AlpenglowIndustries/Alpenglow_RadiantRainbow_PCB/README.md

# Alpenglow_RadiantRainbow_PCB
Cheerful rainbow great for beginning soldering.  Made with KiCad 6
