AlpenglowIndustries/Alpenglow_RadiantRainbow_PCB/Artwork/Blush Bigger Flipped.png

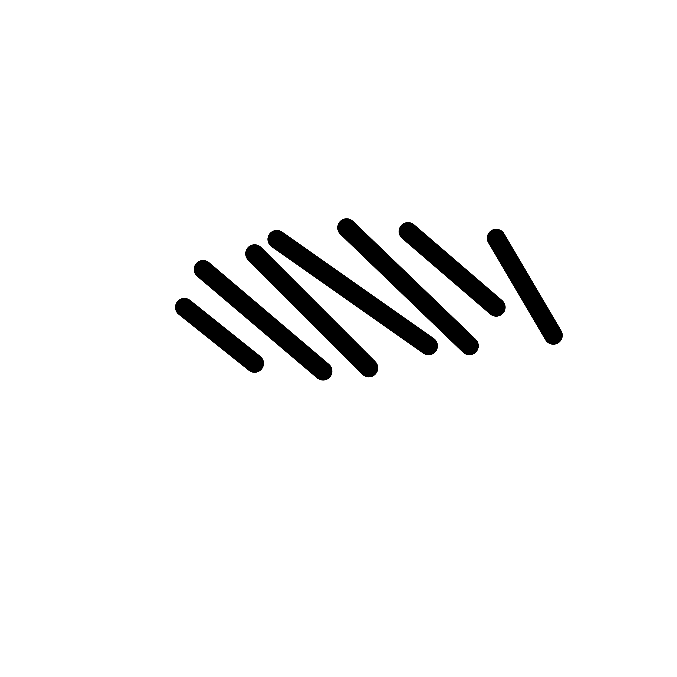
Artwork/Blush Bigger Flipped.png
