AlpenglowIndustries/Alpenglow_RadiantRainbow_PCB/Artwork/Blush Bigger.png

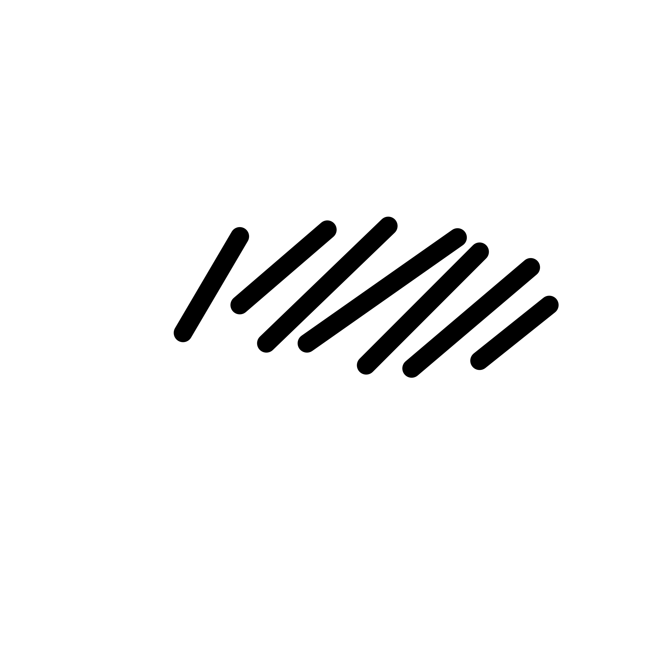
Artwork/Blush Bigger.png
