AlpenglowIndustries/Alpenglow_RadiantRainbow_PCB/Artwork/Cloud Pair for Silk.png

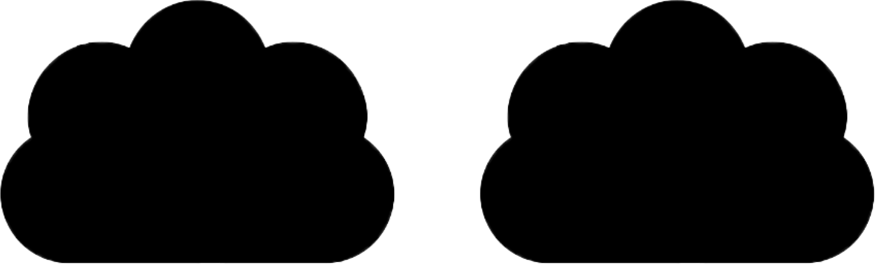
Artwork/Cloud Pair for Silk.png
