AlpenglowIndustries/Alpenglow_RadiantRainbow_PCB/Artwork/raibow lines.png

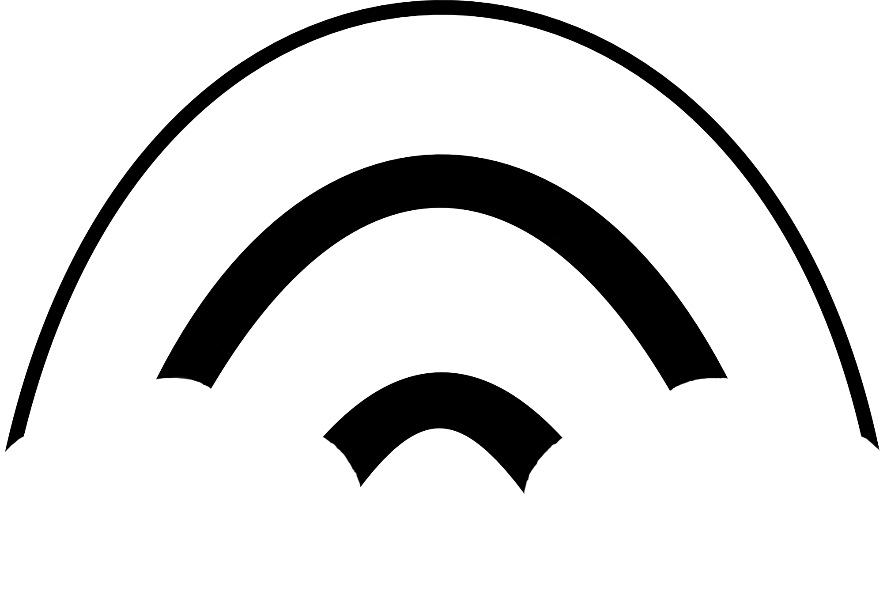
Artwork/raibow lines.png
