AlpenglowIndustries/Alpenglow_RadiantRainbow_PCB/Artwork/Rainbow Filled In More Space for LEDs.png

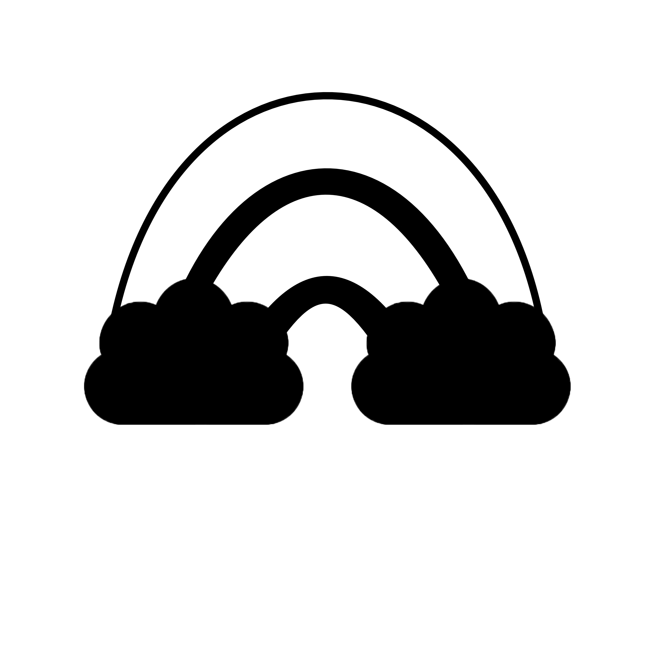
Artwork/Rainbow Filled In More Space for LEDs.png
