AlpenglowIndustries/Alpenglow_RadiantRainbow_PCB/Artwork/RAR board name font 2 lines.png

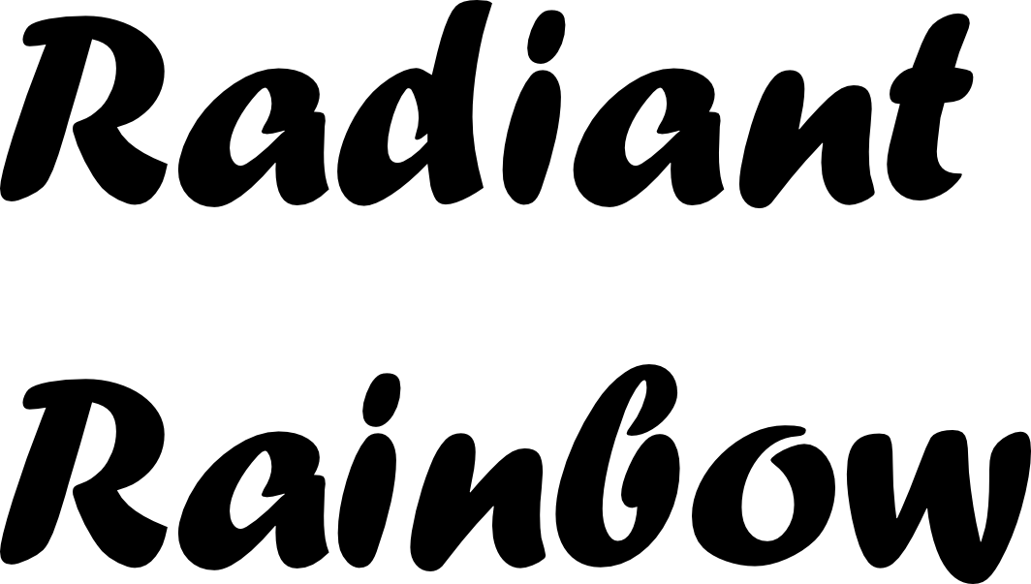
Artwork/RAR board name font 2 lines.png
