AlpenglowIndustries/Alpenglow_RadiantRainbow_PCB/Artwork/RAR board name font.png

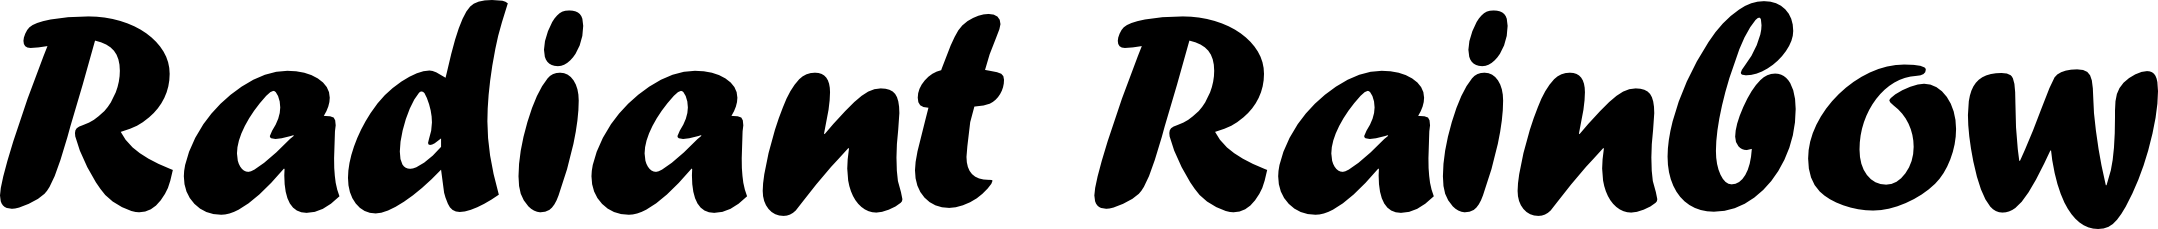
Artwork/RAR board name font.png
