AlpenglowIndustries/Alpenglow_RadiantRainbow_PCB/Alpenglow_RadiantRainbow_PCB.pdf

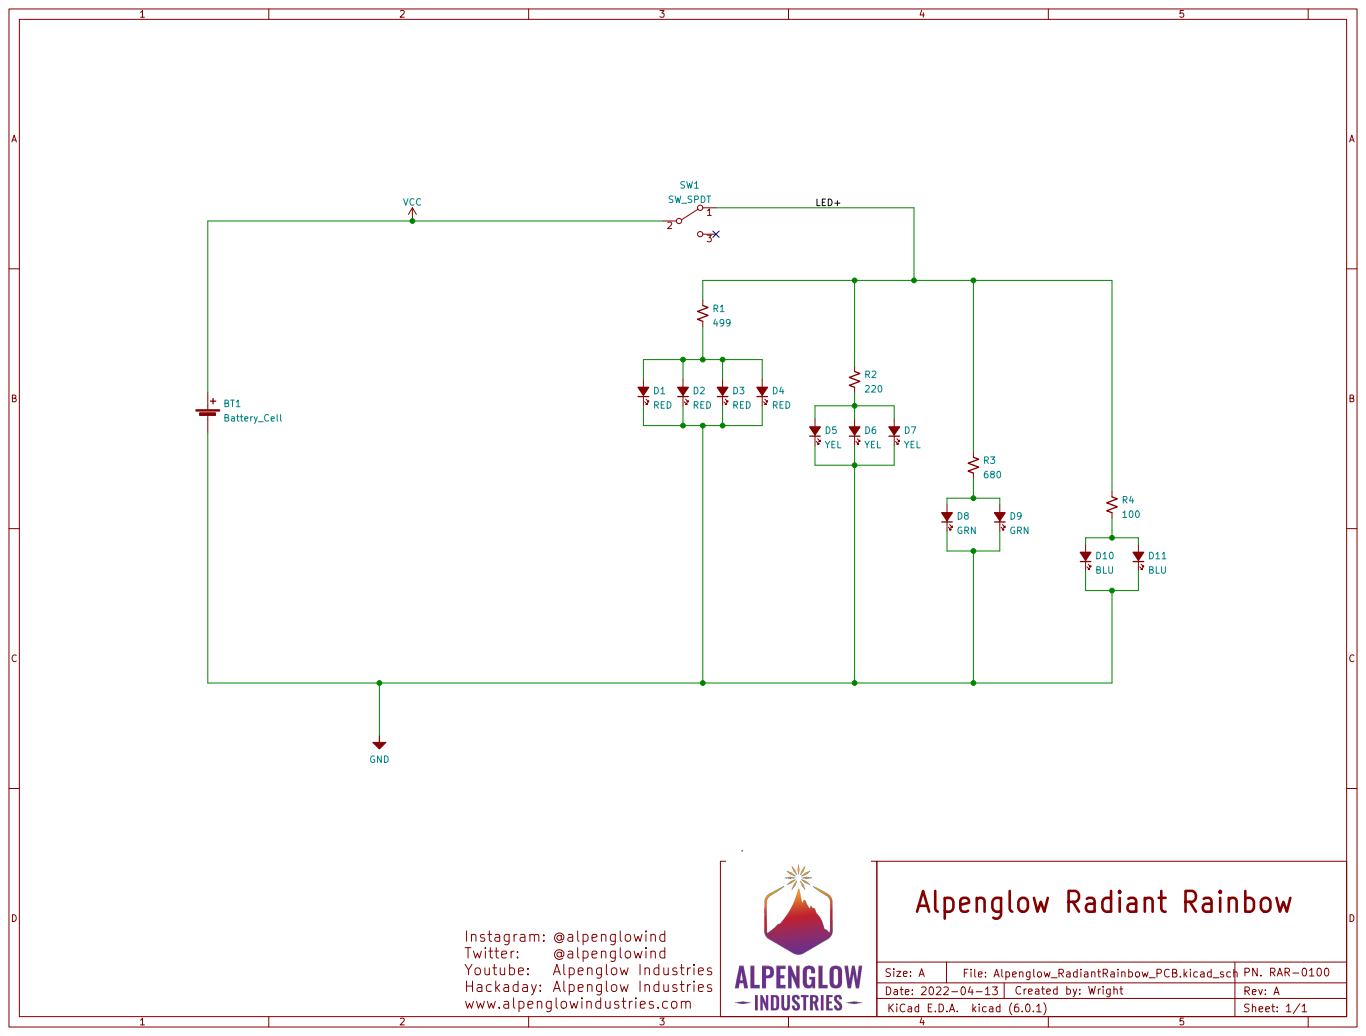
[picture p8: page 1]

www.alpenglowindustries.com Alpenglow Industries | Alpenglow Industries | | Sheet: 1/1 Alpenglow Radiant Rainbow

Size: A
Date: 2022-04-13 KiCad E.D.A. kicad (6.0.1) | | Rev: A
