AlpenglowIndustries/Alpenglow_RadiantRainbow_PCB/Artwork/testcloud.png

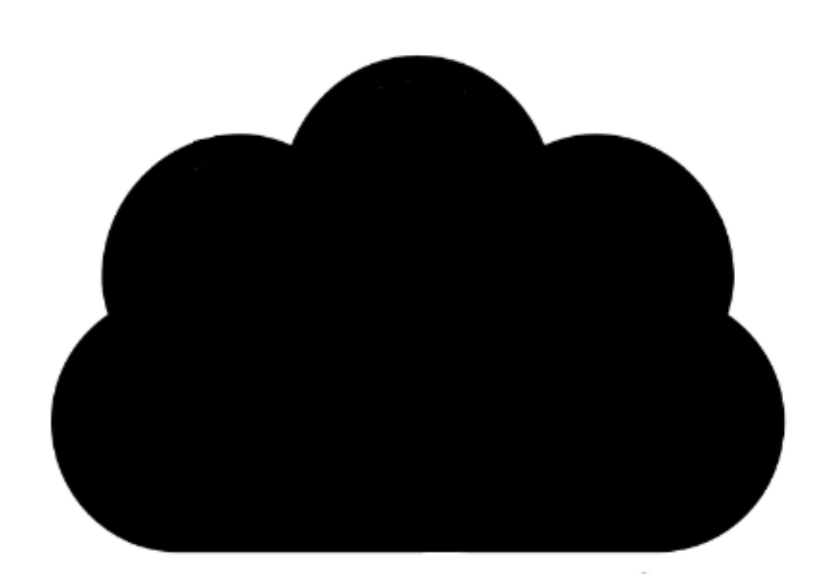
Artwork/testcloud.png
