AlpenglowIndustries/Alpenglow_RadiantRainbow_PCB/(commit log)

2022-04-15 Initial commit of KiCad files
    [Alpenglow_RadiantRainbow_PCB-B_Cu.gbr, Alpenglow_RadiantRainbow_PCB-B_Mask.gbr, Alpenglow_RadiantRainbow_PCB-B_Silkscreen.gbr, Alpenglow_RadiantRainbow_PCB-Edge_Cuts.gbr, Alpenglow_RadiantRainbow_PCB-F_Cu.gbr, Alpenglow_RadiantRainbow_PCB-F_Mask.gbr, Alpenglow_RadiantRainbow_PCB-F_Silkscreen.gbr, Alpenglow_RadiantRainbow_PCB-NPTH.drl]
2022-05-10 Change resistor path on blue LED
    [Alpenglow_RadiantRainbow_PCB.kicad_pcb]
2022-05-20 Made clouds silk and rainbow lines mask.
    [Alpenglow_RadiantRainbow_PCB.kicad_pcb, Alpenglow_RadiantRainbow_PCB.kicad_sch]
2022-05-26 Updated resistor values. Cleaned up foot print library.
    [Alpenglow_RadiantRainbow_PCB.kicad_pcb, Alpenglow_RadiantRainbow_PCB.kicad_sch]
2022-06-01 Updated Final Design
    [Alpenglow_RadiantRainbow_PCB.kicad_pcb]
2022-06-07 Generated gerbers
    [Alpenglow_RadiantRainbow_PCB-B_Cu.gbr, Alpenglow_RadiantRainbow_PCB-B_Mask.gbr, Alpenglow_RadiantRainbow_PCB-B_Silkscreen.gbr, Alpenglow_RadiantRainbow_PCB-Edge_Cuts.gbr, Alpenglow_RadiantRainbow_PCB-F_Cu.gbr, Alpenglow_RadiantRainbow_PCB-F_Mask.gbr, Alpenglow_RadiantRainbow_PCB-F_Silkscreen.gbr, Alpenglow_RadiantRainbow_PCB-NPTH.drl]
2022-07-20 Updated resistor value designator
    [Alpenglow_RadiantRainbow_PCB.kicad_pcb]
2022-09-15 Updated board name with font, updated @alpenglowind with oswald font
    [Alpenglow_RadiantRainbow_PCB.kicad_pcb]
2022-09-16 Updated schematic, Kept mounting pins connected to GND to have the b.cu connected
    [Alpenglow_RadiantRainbow_PCB.kicad_pcb, Alpenglow_RadiantRainbow_PCB.kicad_sch]
2022-10-27 updated BOM, Schematic PDF
    [RadiantRainbow BOM Instructions.xlsx]
2022-10-27 Updated gitignore, changed BOM to CSV file
    [RadiantRainbow BOM Instructions.csv, RadiantRainbow BOM Instructions.xlsx]
2024-01-03 Updated Switch, Removed GND pour and added GND traces, Updated artwork
    [Alpenglow_RadiantRainbow_PCB.kicad_pcb, Alpenglow_RadiantRainbow_PCB.kicad_sch]
2024-01-12 cleaned up some traces
    [Alpenglow_RadiantRainbow_PCB.kicad_pcb]
2024-01-16 Made LED refs same size, Updated font, Changed via to mounting hole
    [Alpenglow_RadiantRainbow_PCB.kicad_pcb]
2024-01-19 added fab notes, generated gerbers
    [Alpenglow_RadiantRainbow_PCB-B_Cu.gbr, Alpenglow_RadiantRainbow_PCB-B_Mask.gbr, Alpenglow_RadiantRainbow_PCB-B_Silkscreen.gbr, Alpenglow_RadiantRainbow_PCB-Edge_Cuts.gbr, Alpenglow_RadiantRainbow_PCB-F_Cu.gbr, Alpenglow_RadiantRainbow_PCB-F_Mask.gbr, Alpenglow_RadiantRainbow_PCB-F_Silkscreen.gbr, Alpenglow_RadiantRainbow_PCB-NPTH.drl]
